trent229/Autonomous-Pan-Tilt-Tracking-Camera/images/02-fusion360-exploded-view.jpg

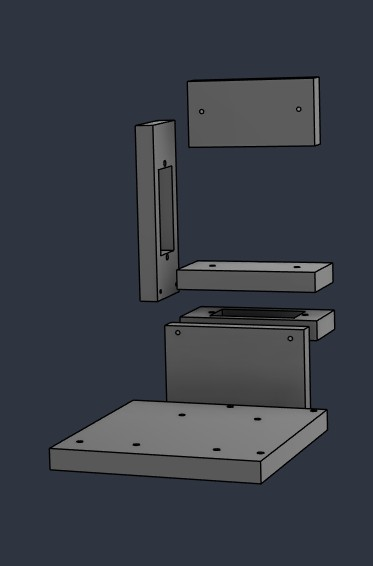
images/02-fusion360-exploded-view.jpg
