trent229/Autonomous-Pan-Tilt-Tracking-Camera/images/03-fusion360-top-view.jpg

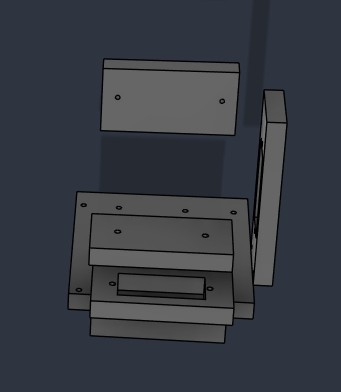
images/03-fusion360-top-view.jpg
