trent229/Autonomous-Pan-Tilt-Tracking-Camera/images/04-fusion360-workspace-v3.jpg

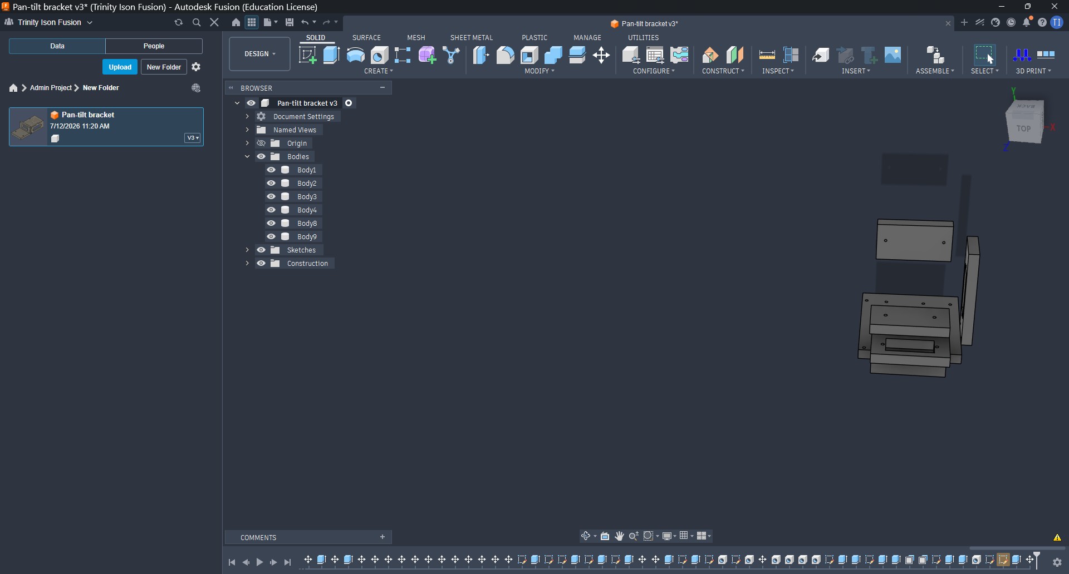
images/04-fusion360-workspace-v3.jpg
